beowolf9867/Piano/README.org

* Piano Project: 25-Key Capacitive Touch Piano

** Equipment
- 5 x Multiplexers: *74HC4051* 8-Channel Analog Mux
- 1 x il matto Development Board (ATmega644P)
- 25 x 10MΩ Resistors (for touch sensing)
- 1 x 100Ω Resistor (for audio protection)
- Copper Tape (Double-sided conductive adhesive)
- Basswood Sheets (30x30cm)
- 3.5mm Headphone Jack

** Pin Mapping (ATmega644P)
*** Analog Inputs (ADC)
Used to read the voltage from each multiplexer.
- MUX 1 (Keys 1-8)  -> PA0
- MUX 2 (Keys 9-16) -> PA1
- MUX 3 (Keys 17-24)-> PA2
- MUX 4 (Key 25)    -> PA3

*** Control & Output
- Address Pins (Shared): PC0 (A), PC1 (B), PC2 (C)
- Charge Driver Pin: PC3 
- Audio Output: PD7 (OC2A PWM)

** Construction
*** 1. The Multiplexers (74HC4051)

**** Power & Enable (Shared across all chips)
- Pin 16 (VCC): 5V rail.
- Pin 8 (GND) & Pin 7 (VEE): GND rail.
- Pin 6 (INH): GND 

**** Address Selection (Shared across all chips)
- Pin 11 (A): PC0.
- Pin 10 (B): PC1.
- Pin 9 (C): PC2.

**** Signal Output
- MUX 1 Pin 3 (COM): PA0.
- MUX 2 Pin 3 (COM): PA1.
- MUX 3 Pin 3 (COM): PA2.
- MUX 4 Pin 3 (COM): PA3.

*** 2. Capacitive Touch Keys
- 10MΩ resistor between *PA1* and *VCC*.
  - 10MΩ resistor between *PA2* and *VCC*.
  - 10MΩ resistor between *PA3* and *VCC*.
- *The Keys:* copper tape key to mux input pin (Pins 13, 14, 15, 12, 1, 5, 2, 4).

*** 3. Audio Output
- PD7 to a 100Ω resistor.
- other end to the *Tip* (and *Ring* for stereo) of headphone jack.
- *Sleeve* of the jack to GND.

*** 4. Physical Keyboard
- Cut 25 strips of copper tape.
- Apply to the Basswood board with consistent spacing

** Future Improvements
- octave up and octave down buttons to shift the note table up or down by 12 semitones
- home button to reset the octave shift to 0
- add a lock mechanism to prevent multiple octave shifts from a single button press
- add a function to play a note for a set duration, then stop, to allow for more musical phrases
