beowolf9867/Piano/Simulation/Piano.png

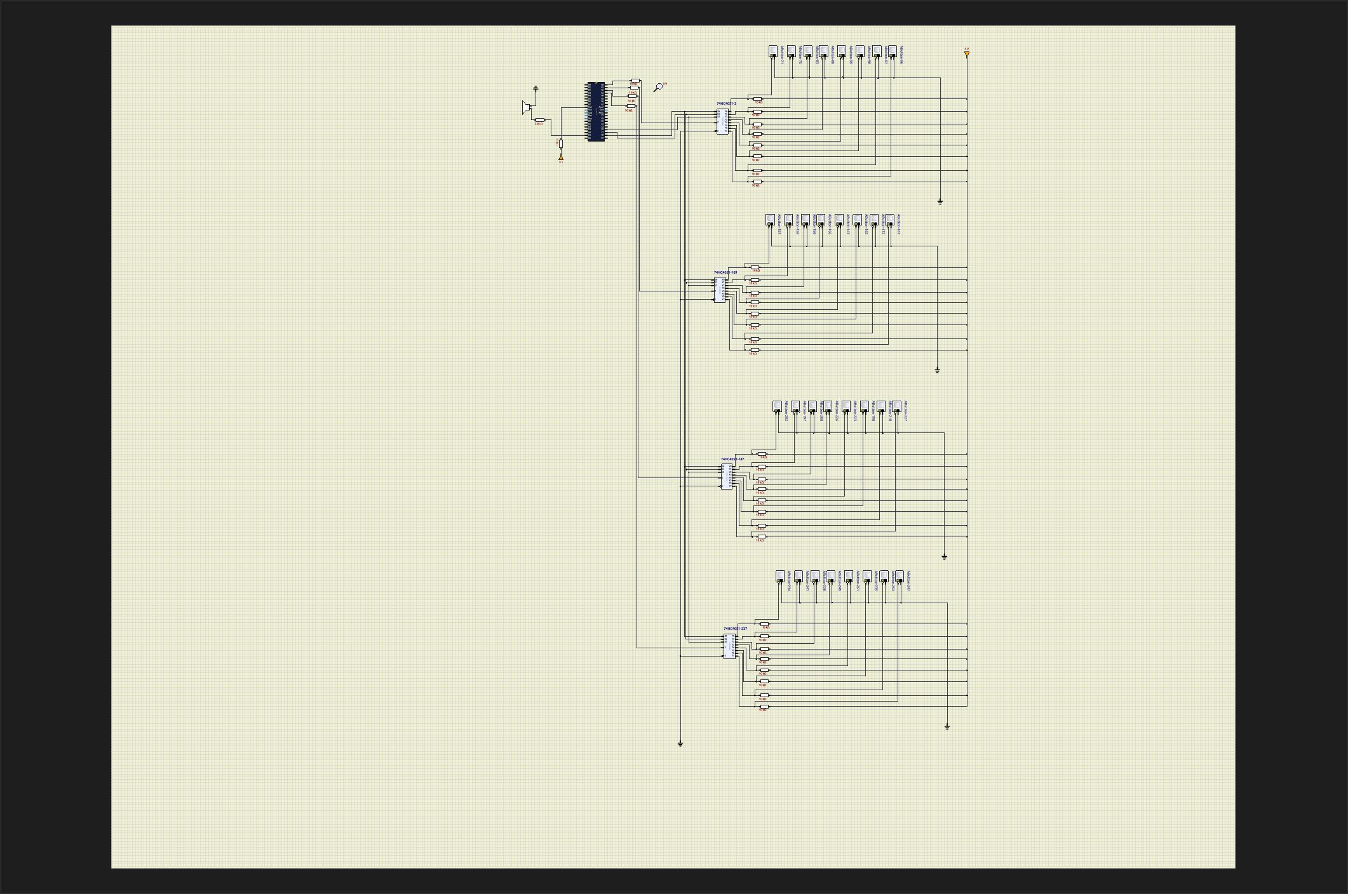
Simulation/Piano.png
