beowolf9867/Piano/(list of files, drawings)

Other design files:
Simulation/Piano(8).sim1
Simulation/Piano.sim1
