beowolf9867/Piano/Piano(2)/note_table.h

const uint16_t note_table[128] = {
    14446,
    13635,
    12870,
    12148,
    11466,
    10822,
    10215,
    9641,
    9100,
    8589,
    8107,
    7652,
    7223,
    6817,
    6435,
    6073,
    5732,
    5411,
    5107,
    4820,
    4550,
    4294,
    4053,
    3826,
    3611,
    3408,
    3217,
    3036,
    2866,
    2705,
    2553,
    2410,
    2274,
    2147,
    2026,
    1912,
    1805,
    1704,
    1608,
    1518,
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
};
