beowolf9867/Piano/(commit log)

2026-10-31 published all files and changes
    [Piano(8).sim1, Piano.sim1, piano.kicad_pcb, piano.kicad_sch]
2026-10-31 updated readme to reflect the new wiring of the piano.
